SPOOKEXE/EEGProject/docs/references.md

# Parse JSON in C++
https://linuxhint.com/parse-json-data-cpp/

# Timestamp in Milliseconds since Epoch
https://www.techiedelight.com/get-current-timestamp-in-milliseconds-since-epoch-in-cpp/

# Standard C++ Libraries for Arduino (port of uClibc++)
https://github.com/ivankravets/StandardCplusplus
