SPOOKEXE/EEGProject/temp/other.md

#### EEG Related

https://github.com/cah6/EEG
https://github.com/meagmohit/EEG-Datasets
https://github.com/pbashivan/EEGLearn

#### other

get code from recycling robot arm
