SPOOKEXE/EEGProject/hardware/circuits/MUX_TRUTH_TABLE.xlsx

64 MUX
 | a | b | c | d | e | f | selected
MUX_1 | 0 | 0 | 0 | 0 | 0 | 0 | 16
2 | 0 | 0 | 0 | 0 | 0 | 1 | 15
3 | 0 | 0 | 0 | 0 | 1 | 0 | 14
4 | 0 | 0 | 0 | 0 | 1 | 1 | 13
5 | 0 | 0 | 0 | 1 | 0 | 0 | 12
6 | 0 | 0 | 0 | 1 | 0 | 1 | 11
7 | 0 | 0 | 0 | 1 | 1 | 0 | 10
8 | 0 | 0 | 0 | 1 | 1 | 1 | 9
1 | 0 | 0 | 1 | 0 | 0 | 0 | 8
2 | 0 | 0 | 1 | 0 | 0 | 1 | 7
3 | 0 | 0 | 1 | 0 | 1 | 0 | 6
4 | 0 | 0 | 1 | 0 | 1 | 1 | 5
5 | 0 | 0 | 1 | 1 | 0 | 0 | 4
6 | 0 | 0 | 1 | 1 | 0 | 1 | 3
7 | 0 | 0 | 1 | 1 | 1 | 0 | 2
8 | 0 | 0 | 1 | 1 | 1 | 1 | 1
MUX_2 | 0 | 1 | 0 | 0 | 0 | 0 | 32
2 | 0 | 1 | 0 | 0 | 0 | 1 | 31
3 | 0 | 1 | 0 | 0 | 1 | 0 | 30
4 | 0 | 1 | 0 | 0 | 1 | 1 | 29
5 | 0 | 1 | 0 | 1 | 0 | 0 | 28
6 | 0 | 1 | 0 | 1 | 0 | 1 | 27
7 | 0 | 1 | 0 | 1 | 1 | 0 | 26
8 | 0 | 1 | 0 | 1 | 1 | 1 | 25
1 | 0 | 1 | 1 | 0 | 0 | 0 | 24
2 | 0 | 1 | 1 | 0 | 0 | 1 | 23
3 | 0 | 1 | 1 | 0 | 1 | 0 | 22
4 | 0 | 1 | 1 | 0 | 1 | 1 | 21
5 | 0 | 1 | 1 | 1 | 0 | 0 | 20
6 | 0 | 1 | 1 | 1 | 0 | 1 | 19
7 | 0 | 1 | 1 | 1 | 1 | 0 | 18
8 | 0 | 1 | 1 | 1 | 1 | 1 | 17
MUX_3 | 1 | 0 | 0 | 0 | 0 | 0 | 48
2 | 1 | 0 | 0 | 0 | 0 | 1 | 47
3 | 1 | 0 | 0 | 0 | 1 | 0 | 46
4 | 1 | 0 | 0 | 0 | 1 | 1 | 45
5 | 1 | 0 | 0 | 1 | 0 | 0 | 44
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
