SPOOKEXE/EEGProject/hardware/1000_F_228822933_SRAq84TM4lXtY45tLT7HI8YFIpgbB2LT.jpg

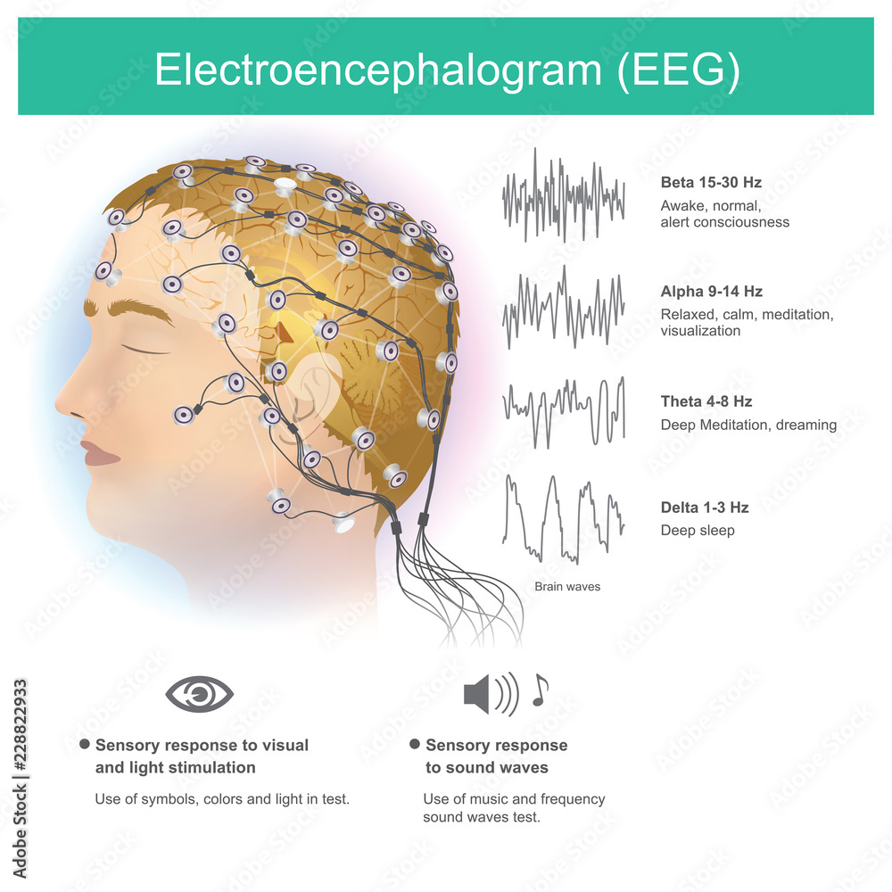
hardware/1000_F_228822933_SRAq84TM4lXtY45tLT7HI8YFIpgbB2LT.jpg
