SPOOKEXE/EEGProject/hardware/circuits/DEMUX_1_to_64.PNG

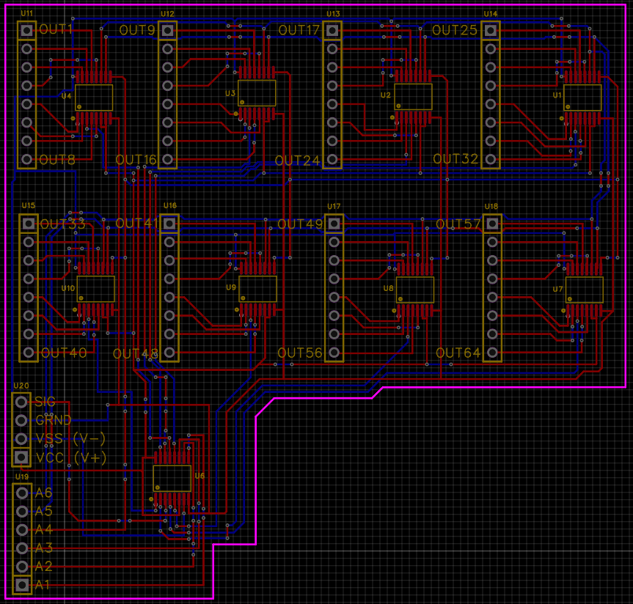
hardware/circuits/DEMUX_1_to_64.PNG
