SPOOKEXE/EEGProject/hardware/circuits/MUX_64_to_1.PNG

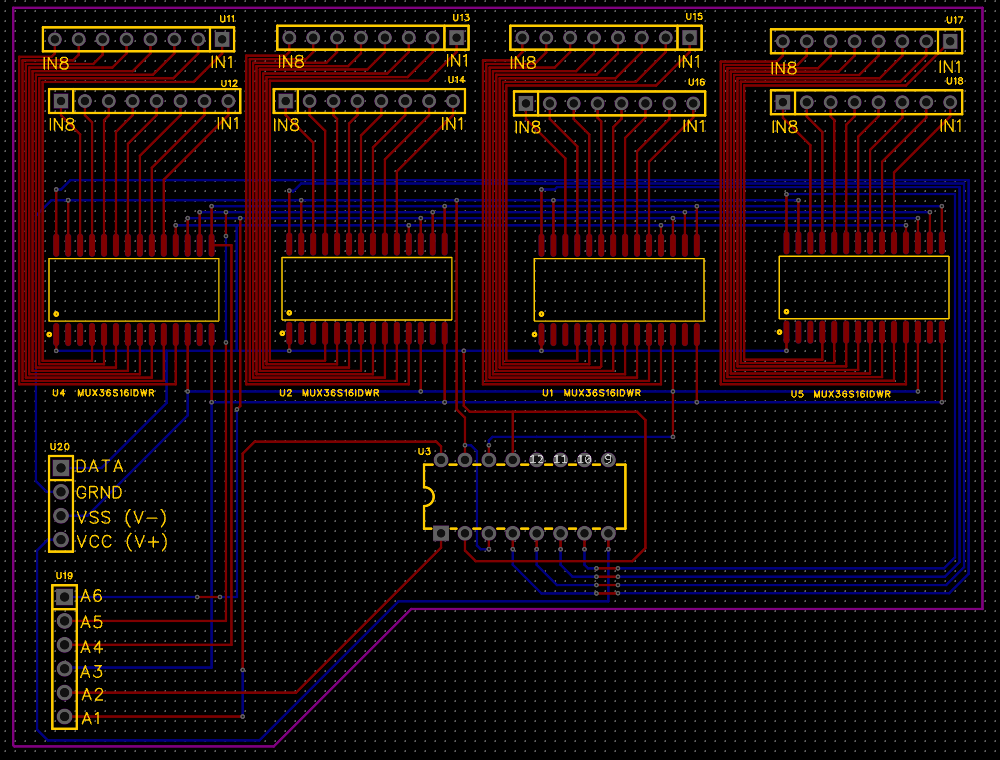
hardware/circuits/MUX_64_to_1.PNG
