SPOOKEXE/EEGProject/hardware/reading_circuit_desgins.png

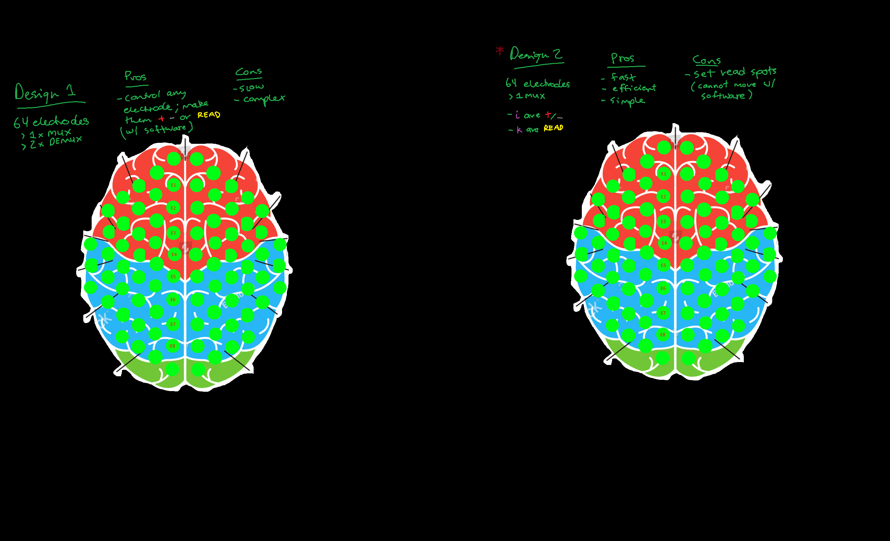
hardware/reading_circuit_desgins.png
