SPOOKEXE/EEGProject/hardware/sample_head.png

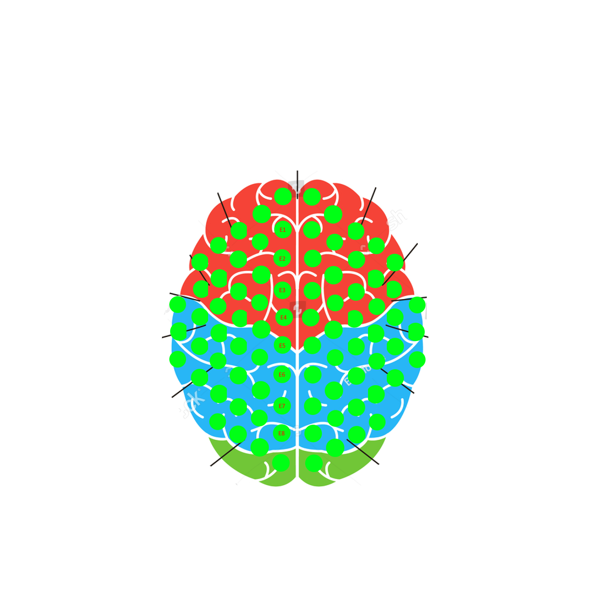
hardware/sample_head.png
