SPOOKEXE/EEGProject/temp/Channel-selection-from-the-high-density-256-electrodes-EEG-The-electrode-layout-is.png

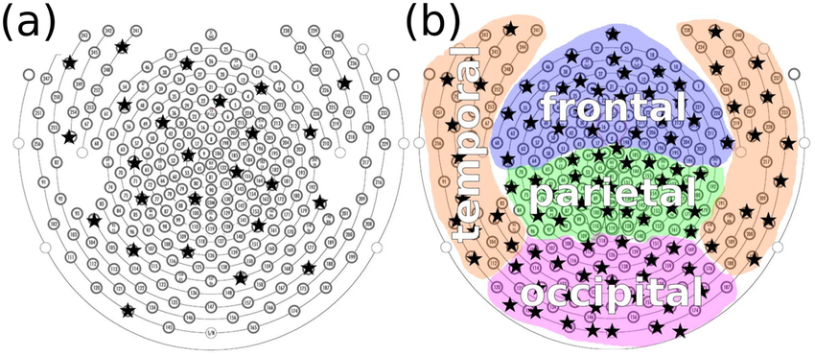
temp/Channel-selection-from-the-high-density-256-electrodes-EEG-The-electrode-layout-is.png
