SPOOKEXE/EEGProject/temp/flowchart.png

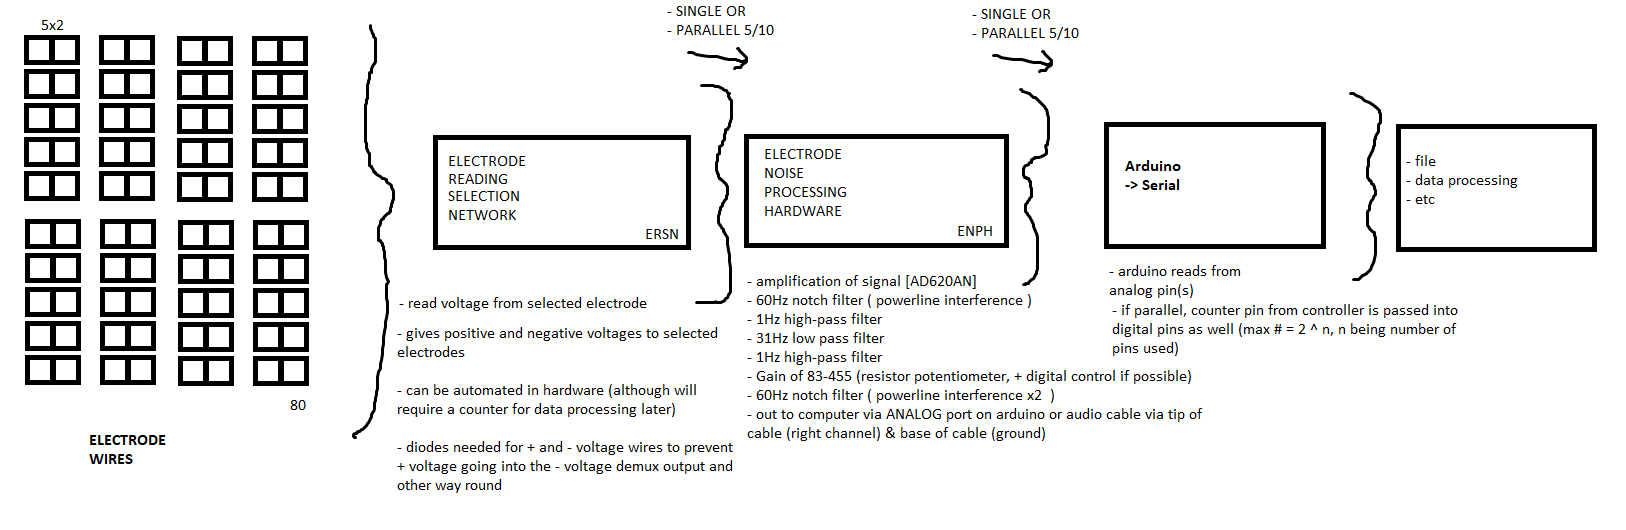
temp/flowchart.png
