SPOOKEXE/EEGProject/temp/flowchart_2.PNG

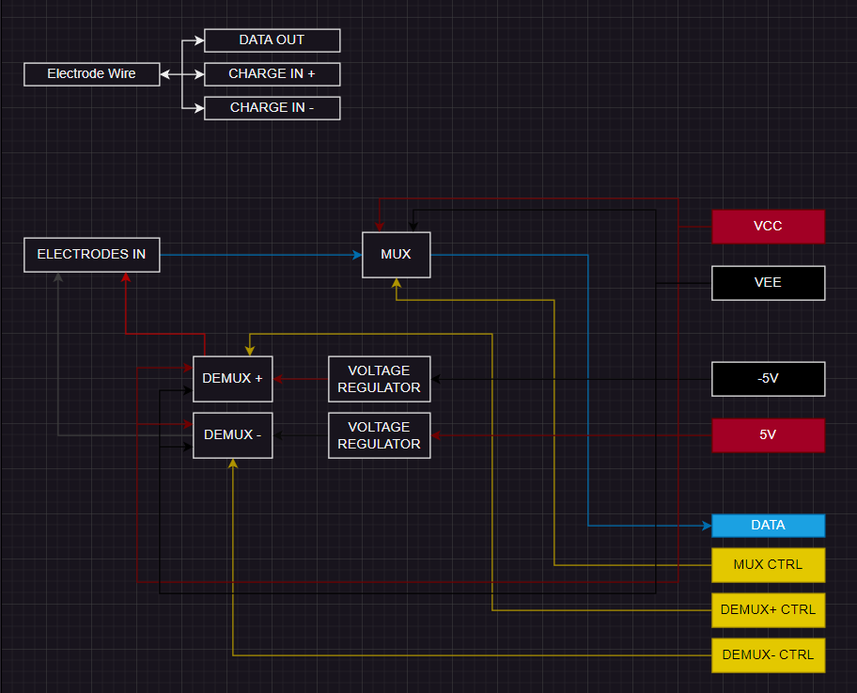
temp/flowchart_2.PNG
