SPOOKEXE/EEGProject/temp/hbm25721-fig-0001-m.jpg

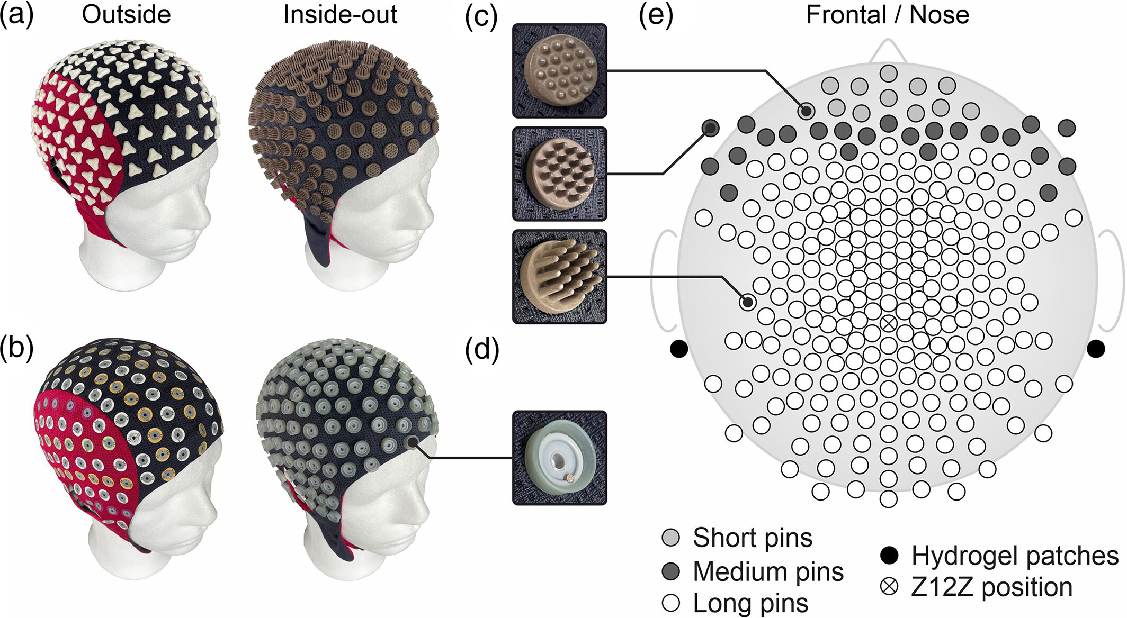
temp/hbm25721-fig-0001-m.jpg
