SPOOKEXE/EEGProject/temp/This-model-is-wearing-the-256-channel-dense-array-EEG-net-Note-the-electrode-coverage.png

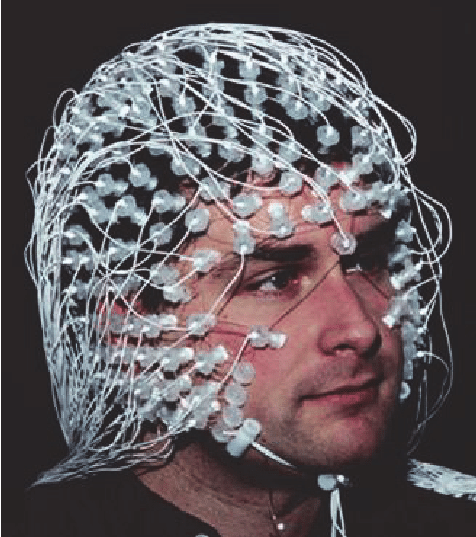
temp/This-model-is-wearing-the-256-channel-dense-array-EEG-net-Note-the-electrode-coverage.png
