SPOOKEXE/EEGProject/hardware/circuits/DEMUX_1-to-64.pdf

U1

# PTMUX4051PWR

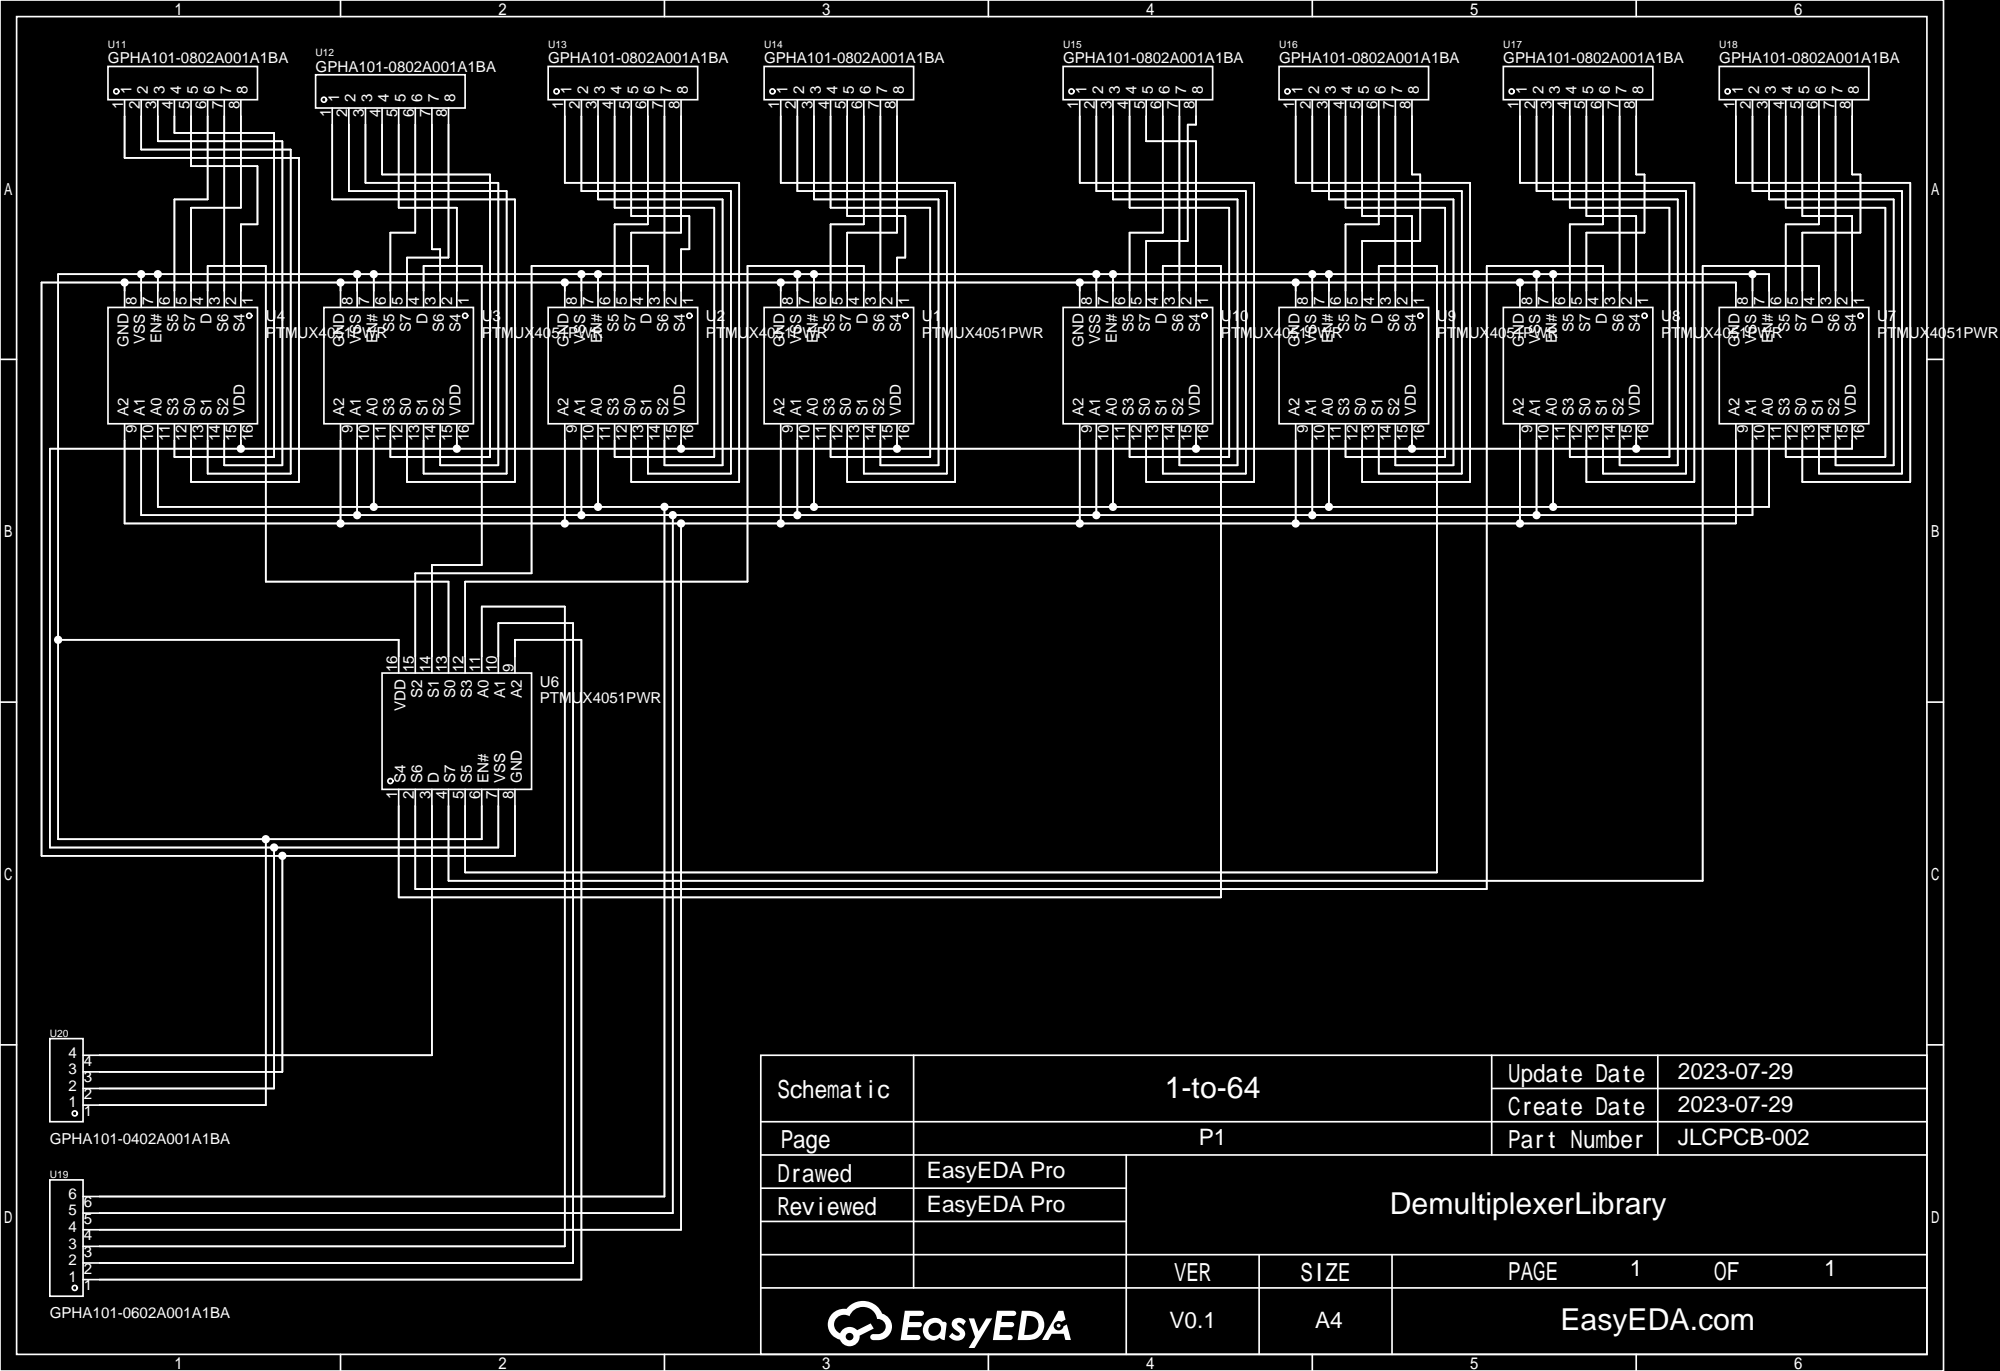
[picture p50: page 1]
