SPOOKEXE/EEGProject/hardware/circuits/MUX_64-to-1.pdf

# P1VDD

U1

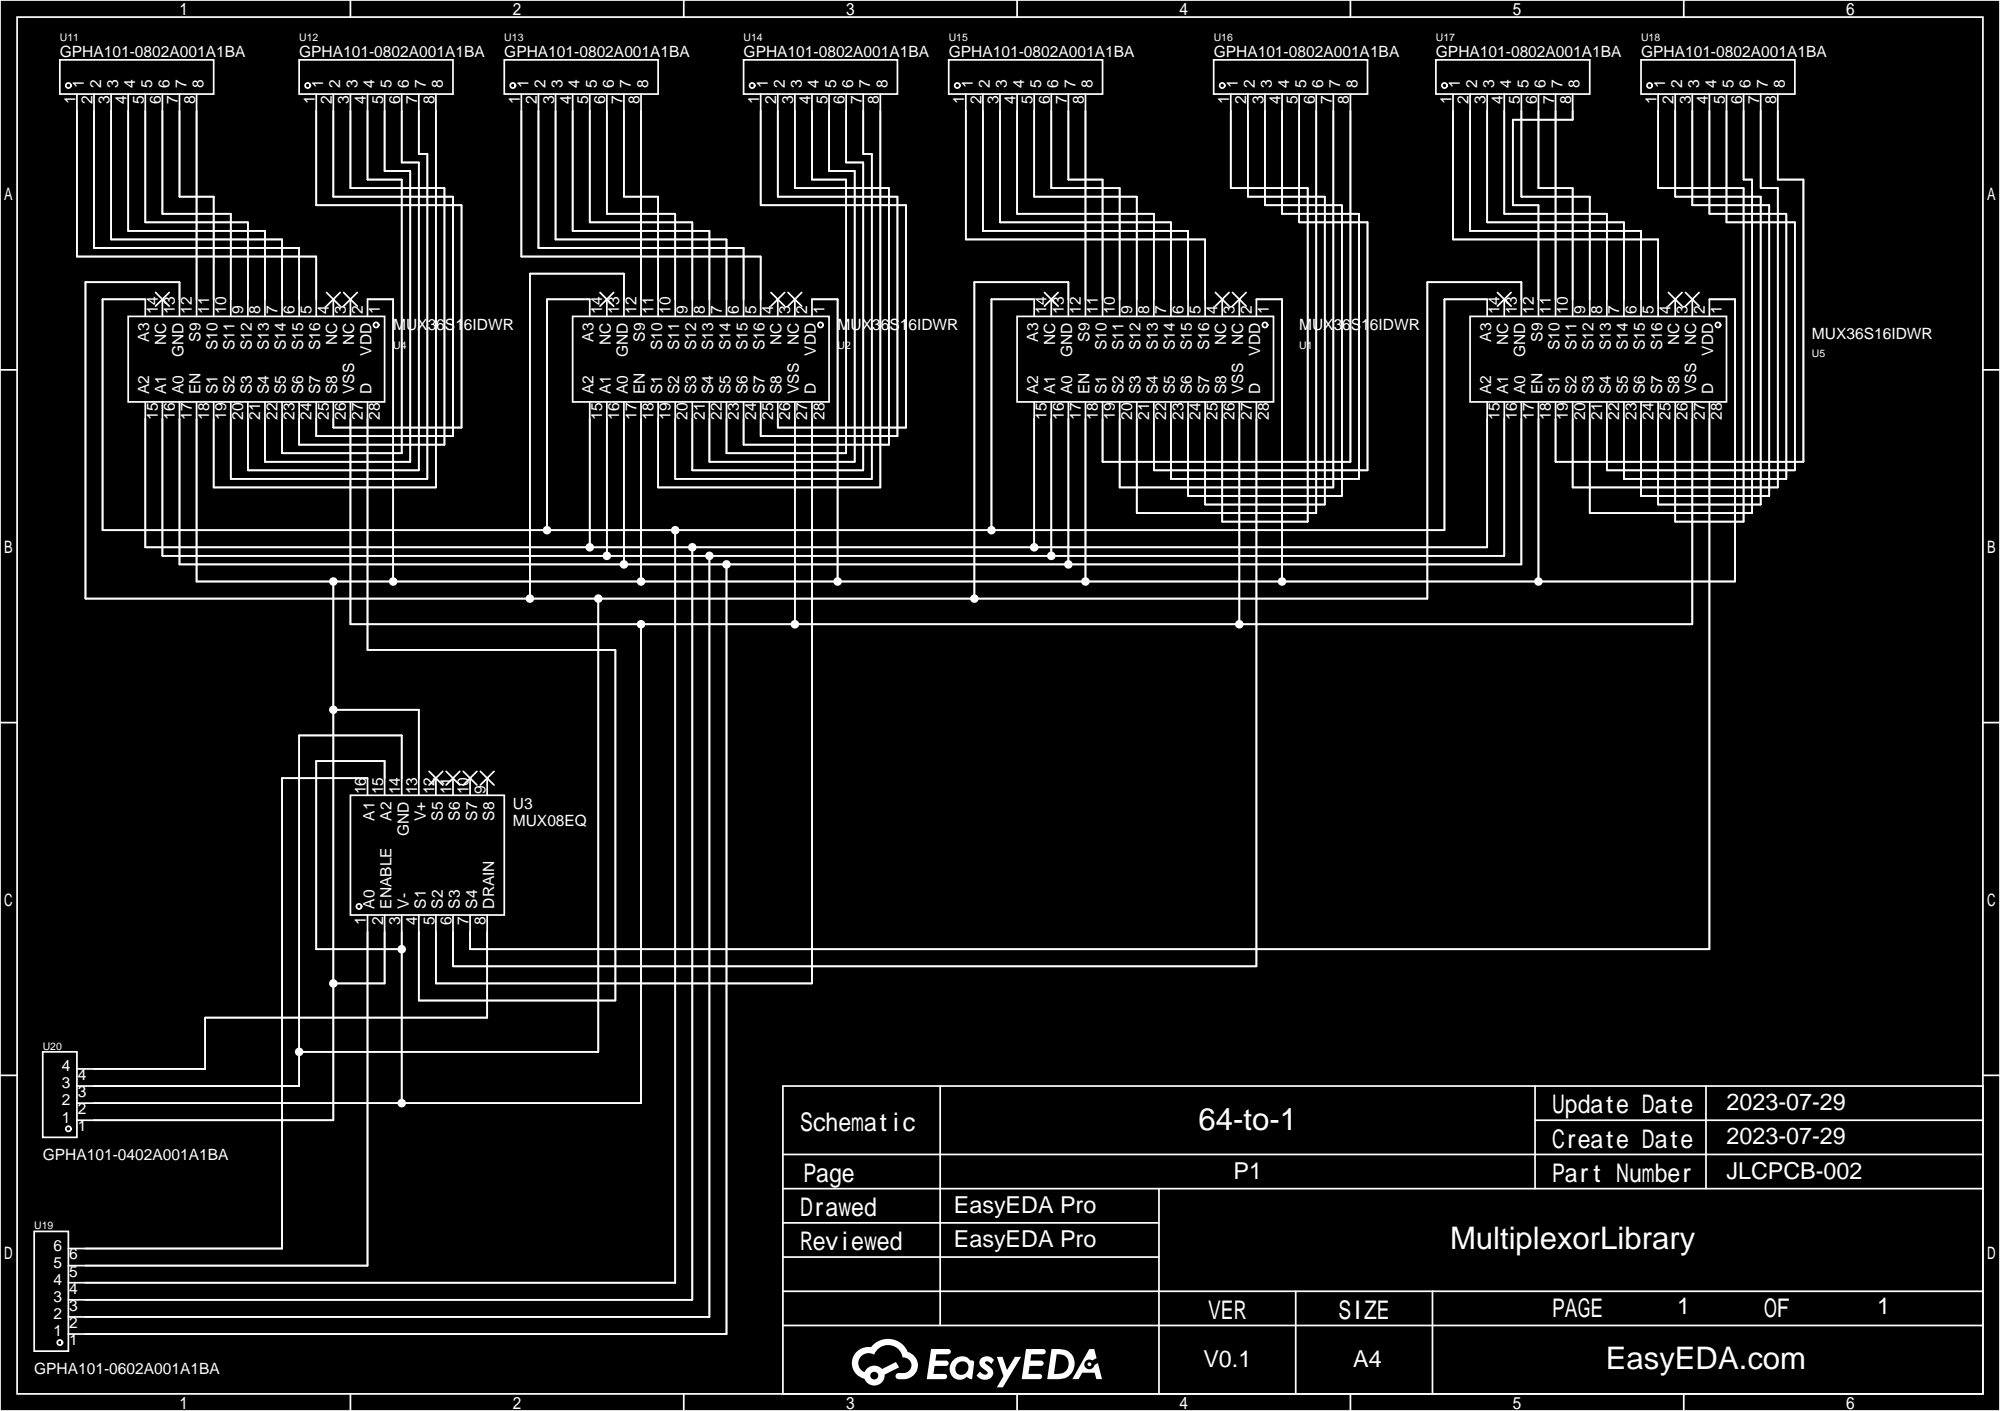
[picture p51: page 1]
