SPOOKEXE/EEGProject/(list of files, drawings)

Other design files:
temp/DemultiplexerLibrary.eprj
temp/MultiplexorLibrary.eprj
