SPOOKEXE/EEGProject/arduino/eeg_design_2/dev_2/ard_esp32.ino

#include "BluetoothSerial.h"
 
#if !defined(CONFIG_BT_ENABLED) || !defined(CONFIG_BLUEDROID_ENABLED)
#error Bluetooth is not enabled! Please run `make menuconfig` to and enable it
#endif

BluetoothSerial SerialBT;

void setup() {
	Serial.begin(115200);
	SerialBT.begin("ESP32test");
	Serial.println("The device started, now you can pair it with bluetooth!");
}

// Middle-man of bluetooth and python
void loop() {

	if (Serial.available()) {
		SerialBT.write(Serial.read());
	}

	if (SerialBT.available()) {
		Serial.write(SerialBT.read());
	}

	delay(20);
}
