SPOOKEXE/EEGProject/hardware/circuits/IMG_8772.jpg

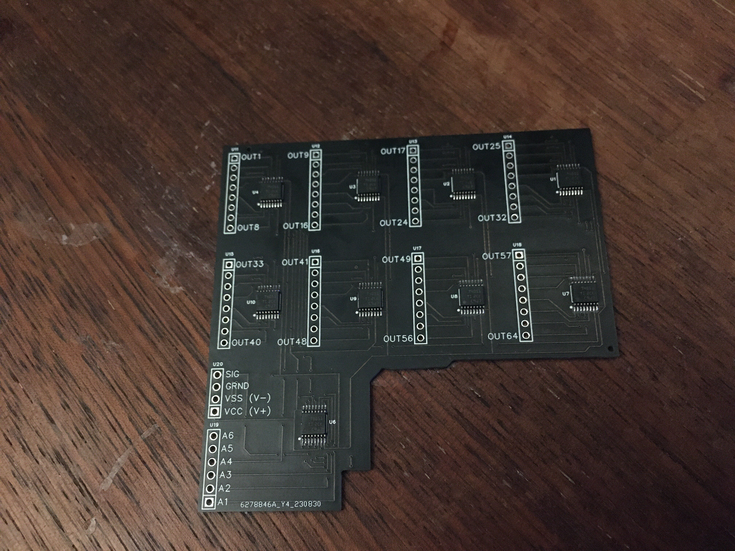
hardware/circuits/IMG_8772.jpg
