SPOOKEXE/EEGProject/hardware/circuits/IMG_8771.jpg

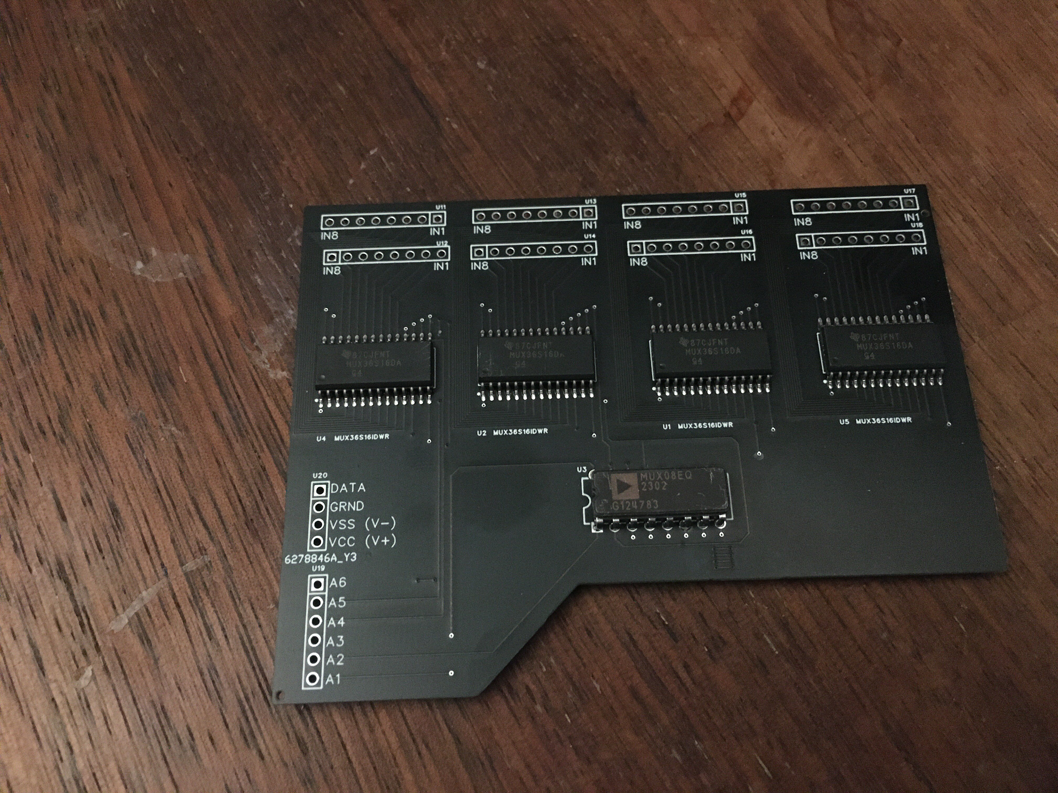
hardware/circuits/IMG_8771.jpg
